acvigue/esp32-airreader/AirReader-(src,fab,asm)/PCBA-AirReader-[NO VARIATIONS]-A.6/BOM/Bill of Materials-AirReader.xlsx

Line # | Name | Description | Designator | Revision ID | Revision Status | Quantity | Manufacturer 1 | Manufacturer Part Number 1 | Manufacturer Lifecycle 1 | Supplier 1 | Supplier Part Number 1 | Supplier Unit Price 1 | Supplier Subtotal 1
 | PTH-M3D5X5 | Plated Thru-Hole M3 D5X5 | *1, *2, *3, *4 | CMP-010-00024-1 | Out of date | 4
 | CC0603JRNPO9BN330 | CAP CER 33PF 50V C0G/NPO 0603 | C1, C2 | CMP-2000-06072-2 | Up to date | 2 | Yageo | CC0603JRNPO9BN330 | Volume Production | Mouser | 603-C0603JRNPO9BN330 | 0.1 | 0.2
 | CL10A106MR8NNNC | Cap Ceramic 10uF 4V X5R ±20% Pad SMD 0603 +85°C T/R | C3, C11, C12, C13, C14, C15 | CMP-13271-001990-1 | Up to date | 6 | Samsung | CL10A106MR8NNNC | Volume Production
 | C0603C102K5RACTU | CAP CER 1000PF 50V X7R 0603 | C4 | CMP-2006-03022-3 | Up to date | 1 | KEMET | C0603C102K5RACTU | Volume Production | Digikey | 399-C0603C102K5RAC7867CT-ND | 0.1 | 0.1
 | C0603C220J1GACTU | CAP CER 22PF 100V 5% NP0 0603 | C5, C10 | CMP-2006-03322-2 | Up to date | 2 | KEMET | C0603C220J1GACTU | Volume Production | Digikey | 399-C0603C220J1GAC7867CT-ND | 0.1 | 0.2
 | VJ0603A101JXACW1BC |  | C6, C8 | CMP-2006-01530-1 | Up to date | 2 | Vishay | VJ0603A101JXACW1BC | Unknown | Mouser | 77-VJ0603A101JXACBC | 0.1 | 0.2
 | VJ0603A221JXACW1BC |  | C7, C9, C16 | CMP-2006-00030-1 | Up to date | 3 | Vishay | VJ0603A221JXACW1BC | Unknown | Mouser | 77-VJ0603A221JXACBC | 0.1 | 0.3
 | MBR120ESFT1G |  | D1 | CMP-1055-00434-2 | Up to date | 1 | ON Semiconductor | MBR120ESFT1G | Volume Production | Mouser | 863-MBR120ESFT1G | 0.48 | 0.48
 | BLM18AG121SN1D | Chip Ferrite Bead, 0603, 120Ω @ 100MHz, 0.18Ω, 25%, 800mA | FB1, FB2 | CMP-0686-00439-3 | Up to date | 2 | Murata | BLM18AG121SN1D | Volume Production | Mouser | 81-BLM11A121S | 0.1 | 0.2
 | USB4110-GF-A | CONN USB 2.0 TYPE-C R/A SMT | J1 | CMP-245163-000002-1 | Up to date | 1
 | TC2030-IDC-NL | CABLE ADAPTER 6 POS | J2 | CMP-070-000001-2 | Up to date | 1
 | BRC1608TR56M | FIXED IND 560NH 760MA 95 MOHM | L1, L2 | CMP-14484-000012-1 | Up to date | 2 | Taiyo Yuden | BRC1608TR56M | Not Recommended for New Design | Digikey | 587-2059-1-ND | 0.29 | 0.58
 | CMT-7525-80-SMT-TR | CMT-7525-80-SMT-TR | LS1 |  |  | 1
 | S2B-PH-SM4-TB(LF)(SN) | Male Header, Pitch 2 mm, 1 x 2 Position, Height 5.5 mm, -25 to 85 degC, RoHS, Tape and Reel | P1 | CMP-1755-00001-1 | Up to date | 1 | JST | S2BPHSM4TBLFSN | Volume Production
 | FDN336P | MOSFET P-CH 20V 1.3A SSOT3 | Q1 | CMP-07173-000103-1 | Up to date | 1 | ON Semiconductor / Fairchild | FDN336P | Volume Production | Digikey | FDN336PCT-ND | 0.43 | 0.43
 | 2N7002 | N-Channel OptiMOS Small-Signal-Transistor, 60 V VDS, 0.3 A ID, -55 to 150 degC, PG-SOT23, Reel, Green | Q2 | CMP-1149-00026-1 | Up to date | 1 | Infineon | 2N7002 | Volume Production | Digikey | 2N7002H6327XTSA2CT-ND | 0.29 | 0.29
 | ERJ-3EKF5101V | RES SMD 5.1K OHM 1% 1/10W 0603 | R1, R2, R9 | CMP-2000-00540-8 | Up to date | 3 | Panasonic | ERJ-3EKF5101V | Volume Production | Mouser | 667-ERJ-3EKF5101V | 0.019 | 0.19
 | ERJ3EKF1002V | Chip Resistor, 10 KOhm, +/- 1%, 0.1 W, -55 to 155 degC, 0603 (1608 Metric), RoHS, Tape and Reel | R3, R10, R11, R12, R13 | CMP-1012-00623-3 | Up to date | 5 | Bourns | CR0603-FX-1002ELF | Volume Production | Mouser | 652-CR0603FX-1002ELF | 0.009 | 0.09
 | RK73H1JTTDD1001F | 1kΩ ±1% 0.125W Chip Resistor 0603 Thick Film AEC-Q200 Qualified | R4 | CMP-2000-01750-2 | Up to date | 1 | KOA Speer | RK73H1JTTDD1001F | Volume Production | Mouser | 660-RK73H1JTTDD1001F | 0.1 | 0.1
 | ERJ-3EKF1691V |  | R5 | CMP-1012-00534-2 | Up to date | 1 | Yageo | RC0603FR-071K69L | Volume Production | Mouser | 603-RC0603FR-071K69L | 0.1 | 0.1
 | RK73B1JTTD152J |  | R6, R7 | CMP-2000-01875-1 | Up to date | 2 | KOA Speer | RK73B1JTTD152J | Volume Production | Mouser | 660-RK73B1JTTD152J | 0.01 | 0.1
 | ERJ-3EKF1003V |  | R8 | CMP-2000-00182-1 | Up to date | 1 | Panasonic | ERJ-3EKF1003V | Volume Production | Digikey | P100KHCT-ND | 0.1 | 0.1
 | 147873-1 | SWITCH TACTILE SPST-NO 0.05A 24V | SW1 | CMP-03407-000005-1 | Up to date | 1 | TE Connectivity | 147873-1 | Unknown | Mouser | 506-147873-1 | 0.26 | 0.26
 | PN5321A3HN/C106,51 | IC RFID RDR/TRAN 13.56MZ 40HVQFN | U1 | CMP-10150-000009-1 | Up to date | 1 | NXP Semiconductors | PN5321A3HN/C106,51 | Volume Production | Mouser | 771-PN5321A3HN10 | 17.74 | 17.74
 | LM1117MPX-3.3/NOPB | 800mA Low-Dropout Linear Regulator, 4-pin SOT-223, Pb-Free | U2 | CMP-0062-01639-4 | Up to date | 1 | TI National Semiconductor | LM1117MPX33NOPB | Unknown
 | MCP73831T-2DCI/OT | IC CONTROLLR LI-ION 4.2V SOT23-5 | U3 | CMP-0133-00146-2 | Up to date | 1 | Microchip | MCP73831T-2DCI/OT | Volume Production | Digikey | MCP73831T-2DCI/OTCT-ND | 0.76 | 0.76
 | ESP32-S3-MINI-1-N8 | Bluetooth, WiFi 802.11b/g/n, Bluetooth v5.0 Transceiver Module 2.4GHz PCB Trace Surface Mount | U4 |  |  | 1 | Espressif Systems | ESP32-S3-MINI-1-N8 | Unknown | Digikey | 1965-ESP32-S3-MINI-1-N8CT-ND | 3.1 | 3.1
 | ATECC608B-MAHDA-S | IC AUTHENTICATION CHIP | U5 | CMP-06260-000008-1 | Up to date | 1 | Microchip | ATECC608B-MAHDA-S | Volume Production | Mouser | 579-TECC608B-MAHDA-S | 0.9 | 0.9
 | WS2812-2020 |  | U6, U7, U8, U9, U10 |  |  | 5
 | ABM11-27.120MHZ-B1U-T | Crystal 27.12MHz ±10ppm 10pF SMD-4 2mm x 1.6mm | Y1 | CMP-27762-005978-1 | Up to date | 1 | Abracon | ABM11-27.120MHZ-B1U-T | Volume Production | Digikey | 535-14959-1-ND | 0.51 | 0.51
