acvigue/esp32-airreader/AirReader-(src,fab,asm)/PCBA-AirReader-[NO VARIATIONS]-A.6/Schematic Prints.PDF

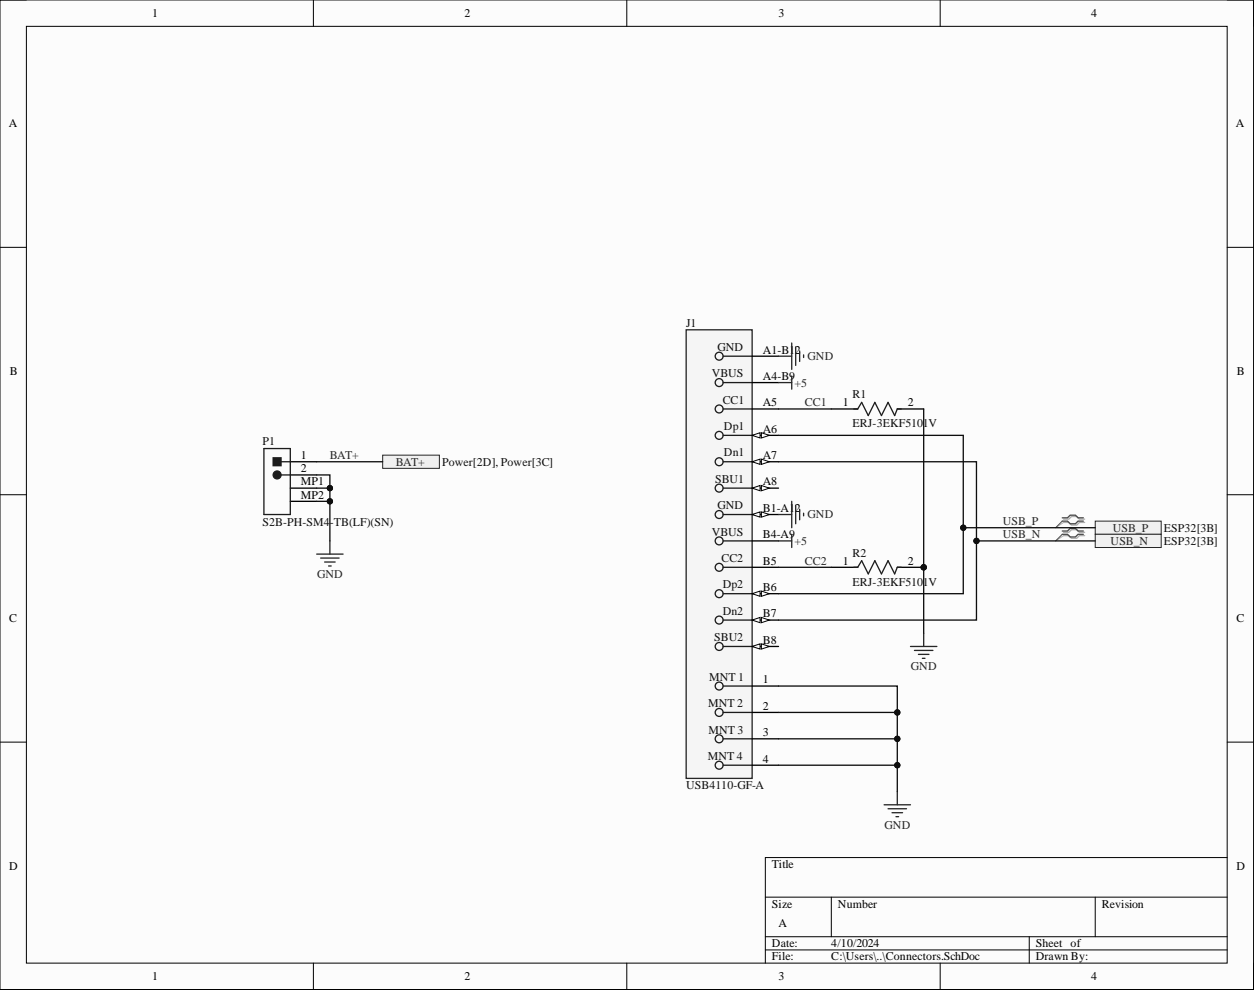
[picture p1: page 1]

MP1
MP2

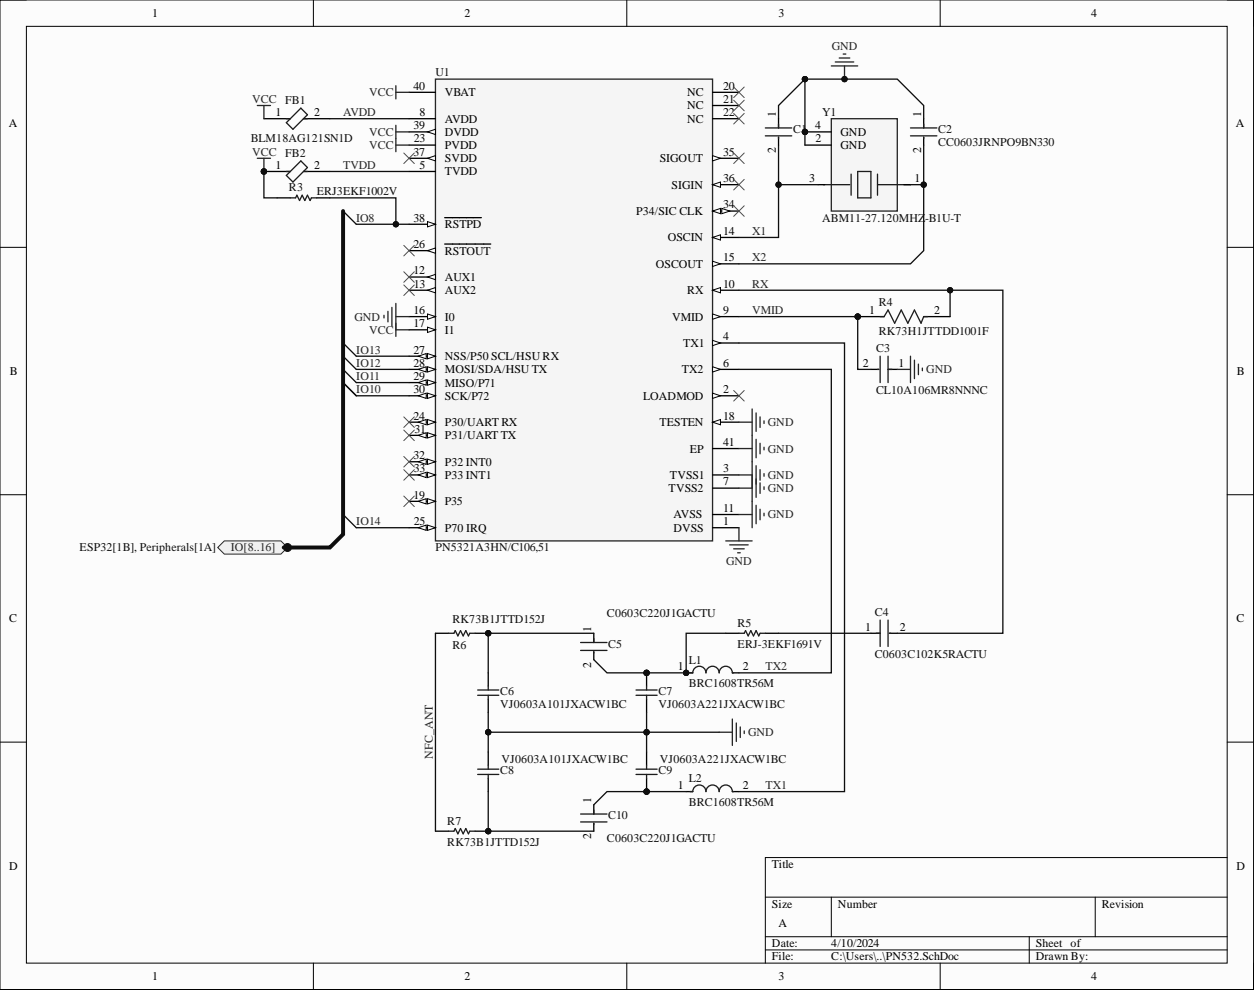
[picture p2: page 2]

1 | ERJ-3EKF1691V 2 L1 TX2

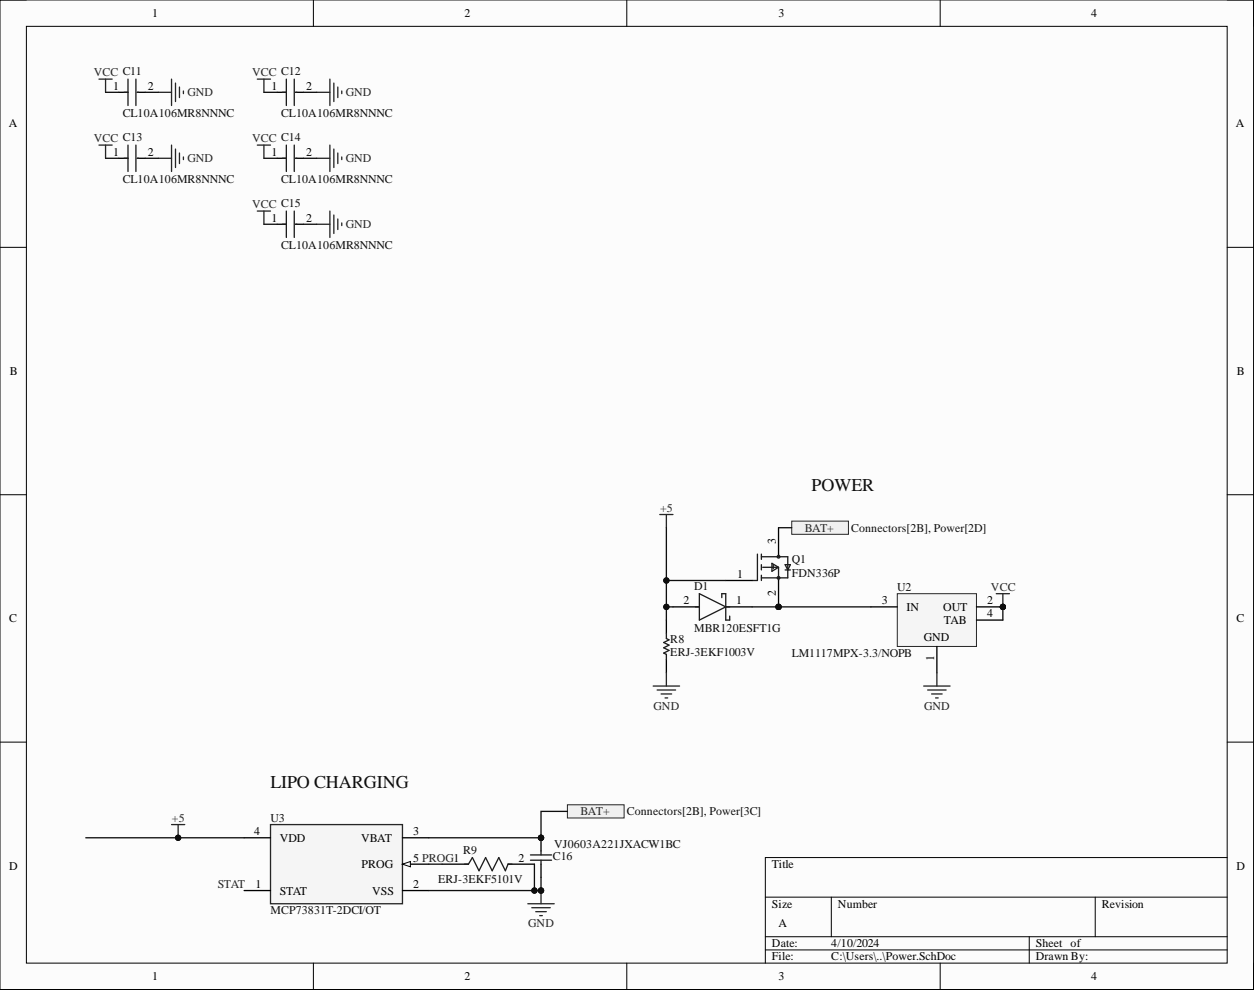
[picture p3: page 3]

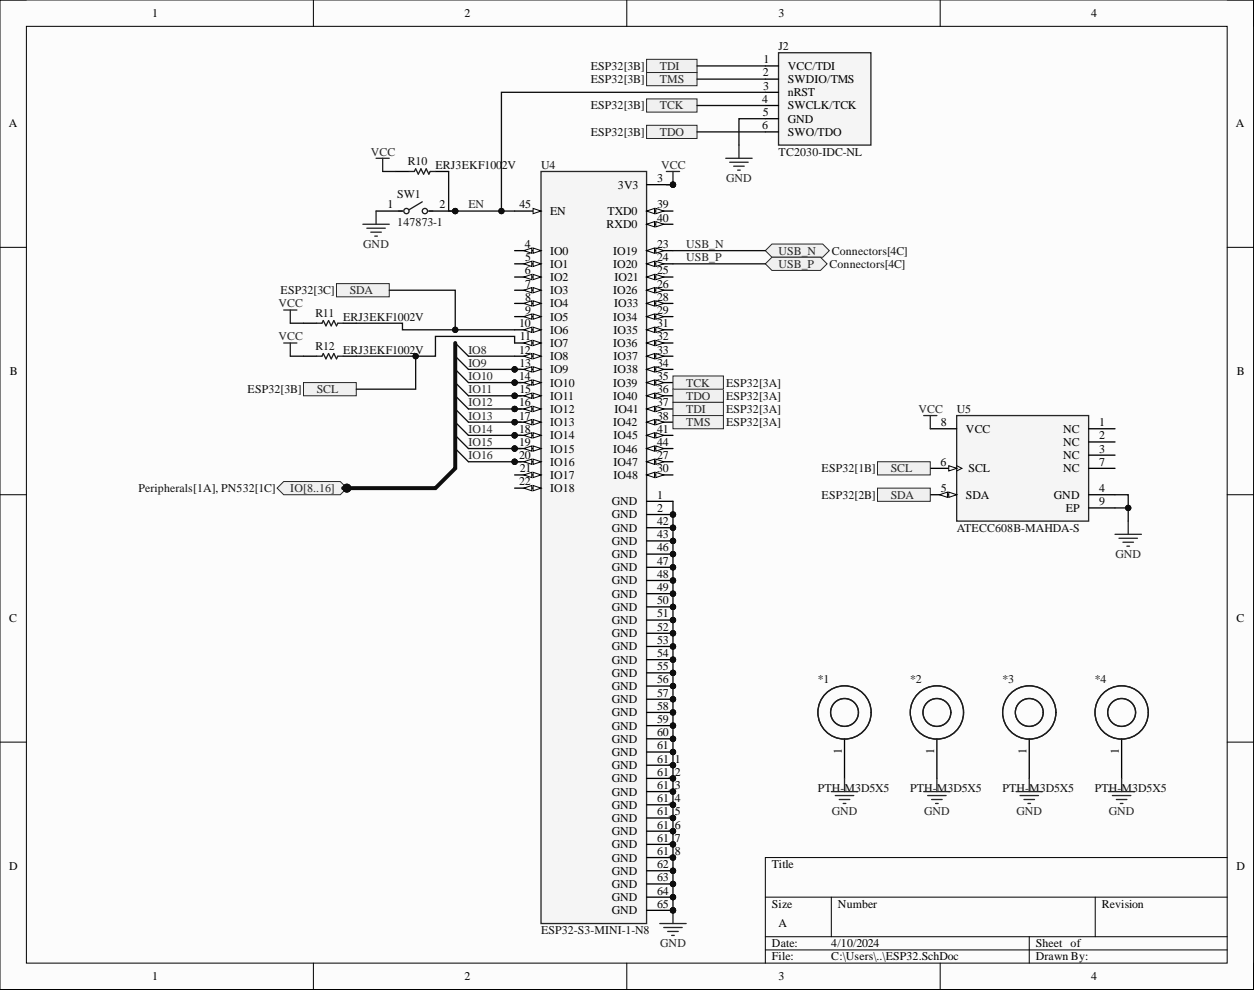
[picture p4: page 4]

U4 | | SWCLK/TCK 4

GND 5

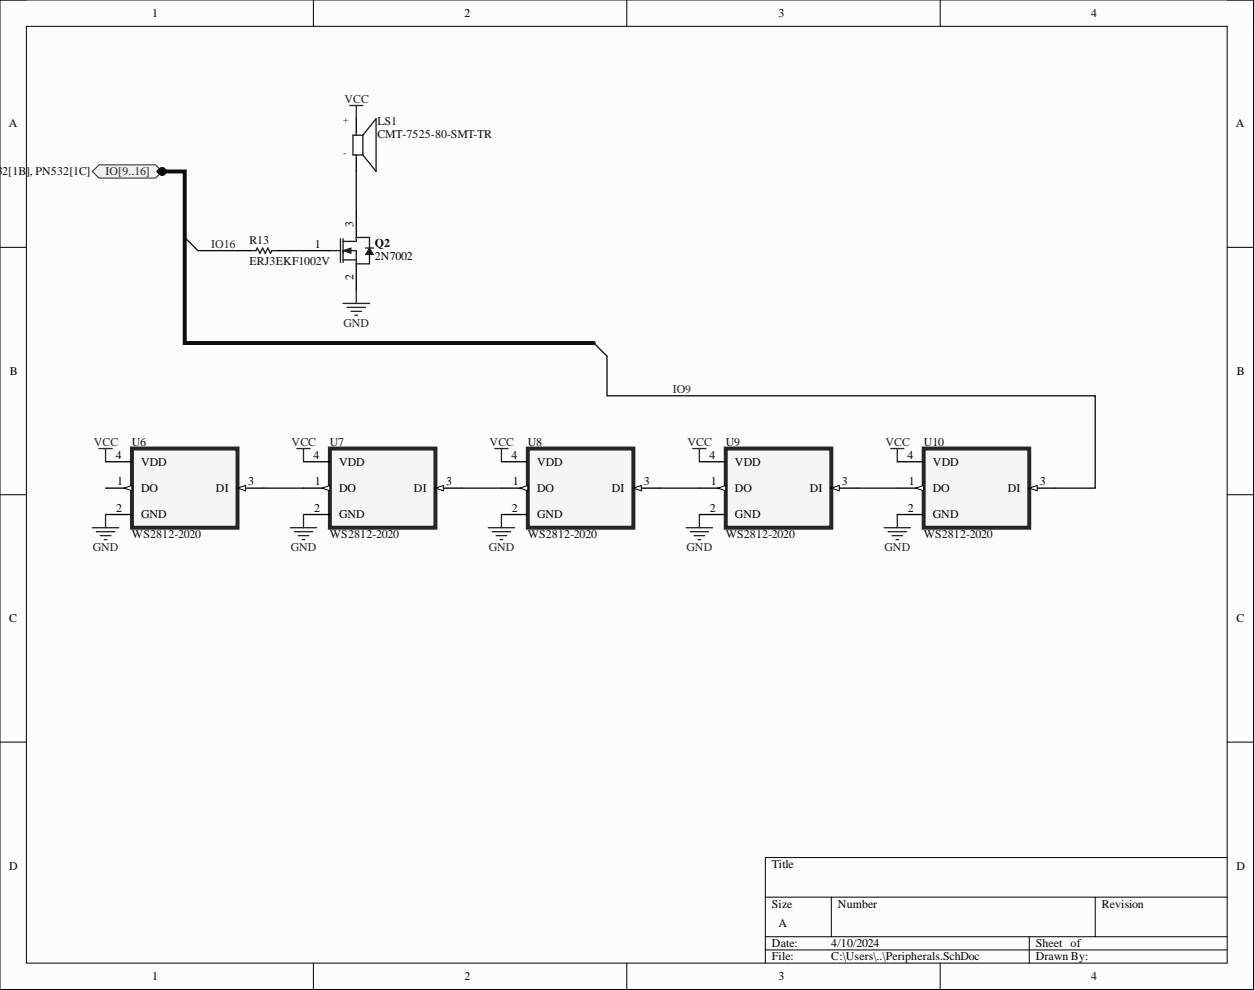
[picture p5: page 5]
