acvigue/esp32-airreader/AirReader-(src,fab,asm)/FAB-AirReader-A.6/Fabrication.pdf

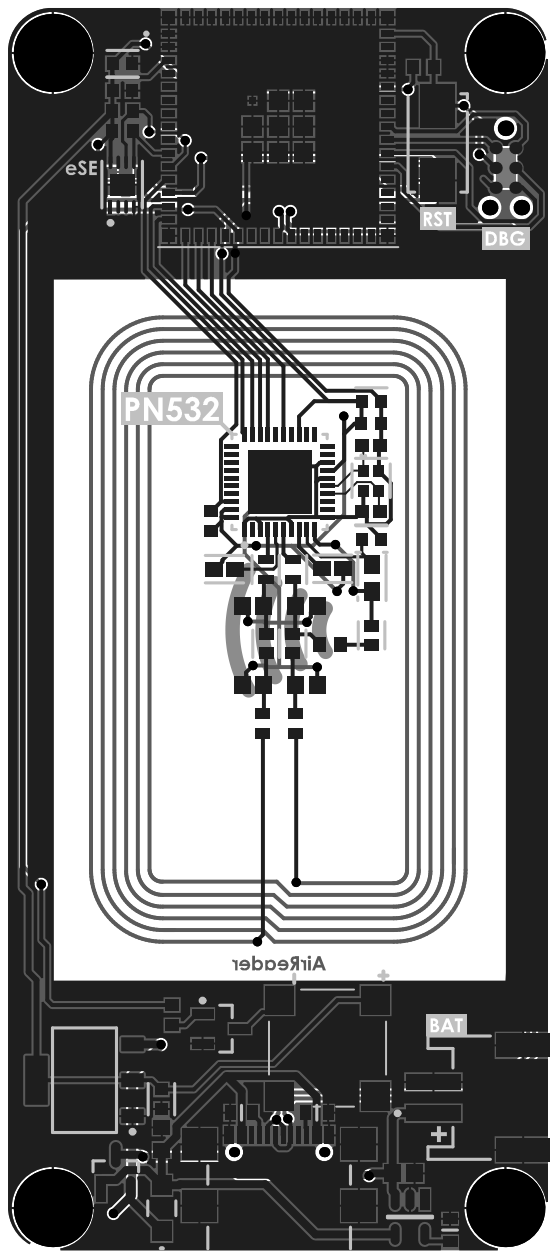
[picture p6: page 1]
