acvigue/esp32-airreader/AirReader-(src,fab,asm)/PCBA-AirReader-[NO VARIATIONS]-A.6/AssemblyDrawing.pdf

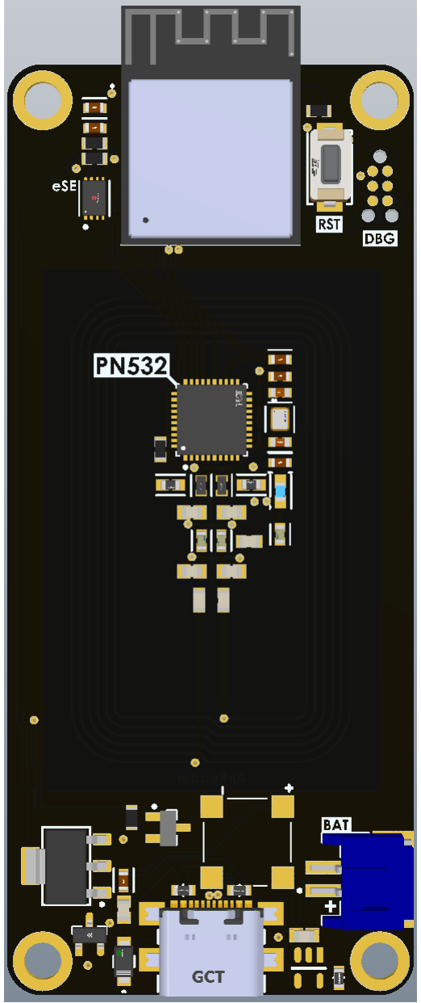
[picture p7: figure]
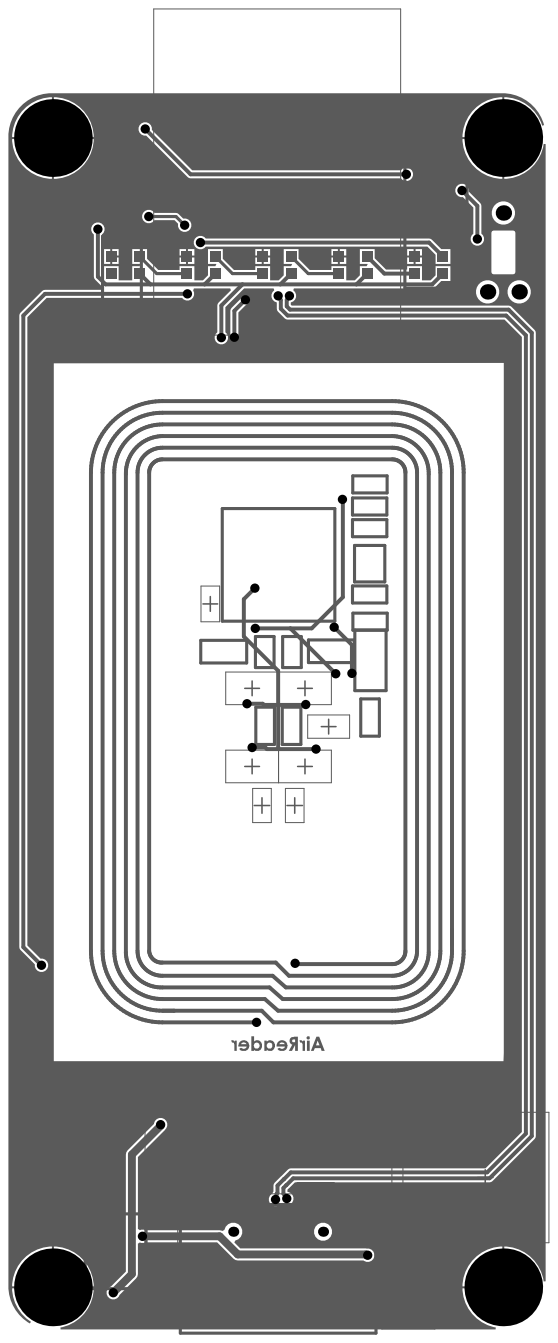
[picture p8: page 2]

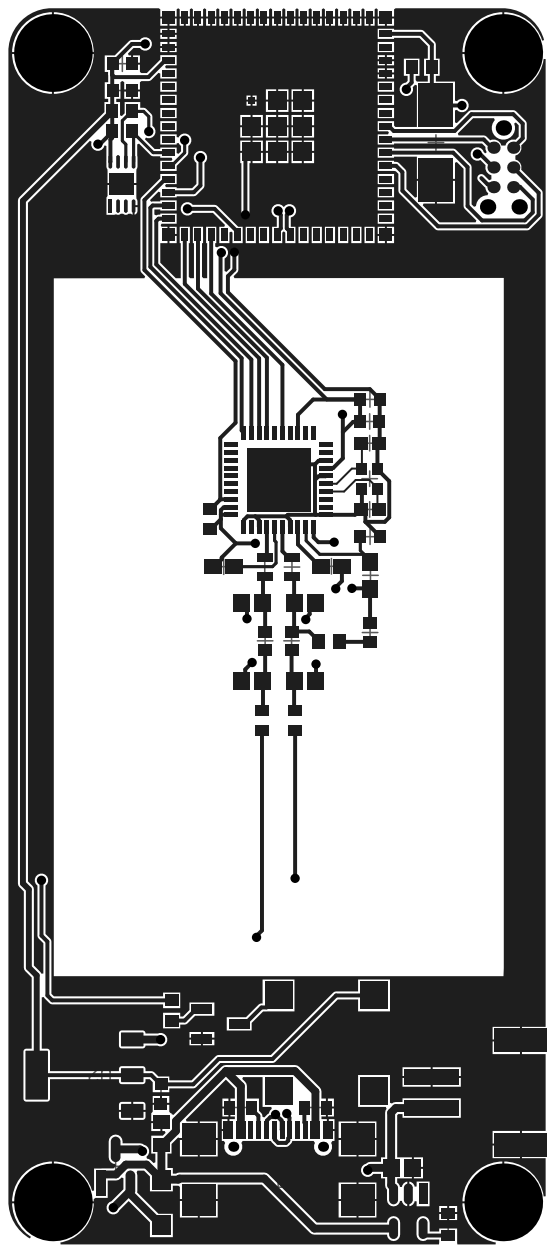
[picture p9: page 3]
