acvigue/esp32-airreader/(list of files, drawings)

Other design files:
AirReader-(src,fab,asm)/FAB-AirReader-A.6/ASCII/AirReader.PcbDoc
AirReader-(src,fab,asm)/SRC-AirReader-A.6/AirReader.PrjPcb
AirReader-(src,fab,asm)/SRC-AirReader-A.6/Connectors.SchDoc
AirReader-(src,fab,asm)/SRC-AirReader-A.6/ESP32.SchDoc
AirReader-(src,fab,asm)/SRC-AirReader-A.6/Peripherals.SchDoc
AirReader-(src,fab,asm)/SRC-AirReader-A.6/PN532.SchDoc
AirReader-(src,fab,asm)/SRC-AirReader-A.6/Power.SchDoc
AirReader-(src,fab,asm)/SRC-AirReader-A.6/SnapDocs/CMT-7525-80-SMT-TR.PcbLib
AirReader-(src,fab,asm)/SRC-AirReader-A.6/SnapDocs/CMT-7525-80-SMT-TR.SchLib
AirReader-(src,fab,asm)/SRC-AirReader-A.6/SnapDocs/ESP32-S3-MINI-1-N8.PcbLib
AirReader-(src,fab,asm)/SRC-AirReader-A.6/SnapDocs/ESP32-S3-MINI-1-N8.SchLib
AirReader-(src,fab,asm)/SRC-AirReader-A.6/SnapDocs/WS2812-2020.PcbLib
AirReader-(src,fab,asm)/SRC-AirReader-A.6/SnapDocs/WS2812-2020.SchLib
